borgel/BotBall/EE/BB-Mainboard-0/BB-Mainboard-0.step

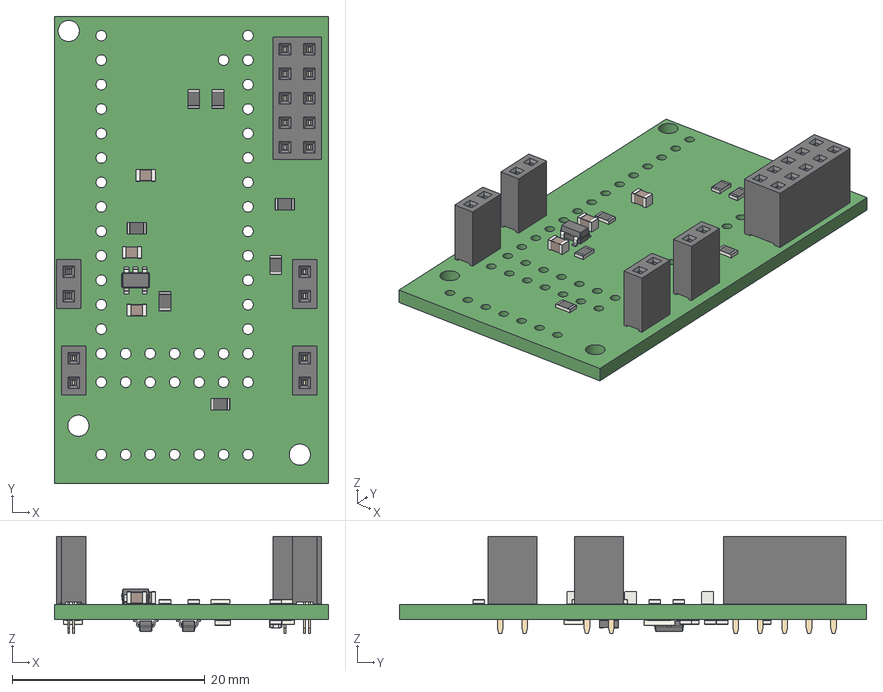
[picture p1: CAD file, 2019-11-15]
EE/BB-Mainboard-0/BB-Mainboard-0.step
28.5 x 48.5 x 10.1 mm
