borgel/BotBall/ME/1x Chassis.stl

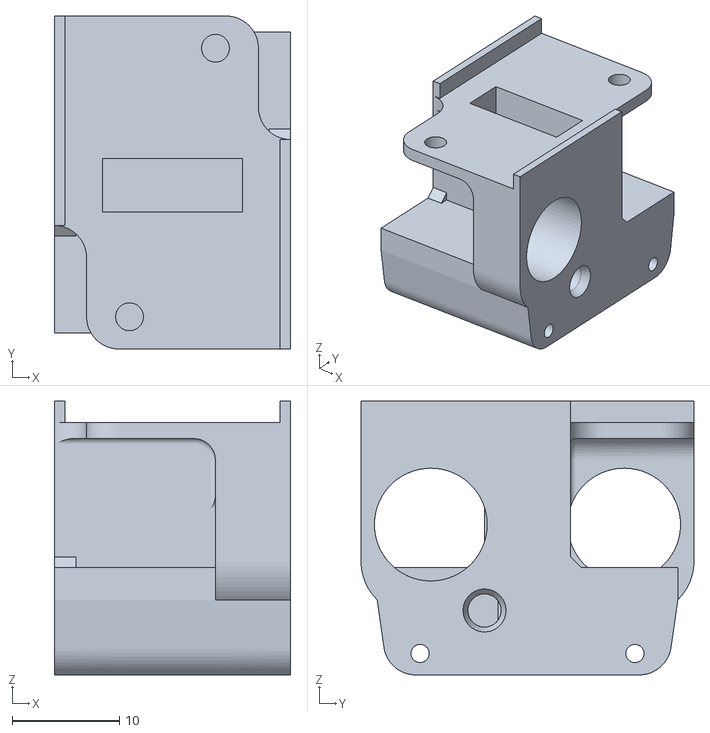
[picture p2: CAD file, 2019-11-15]
ME/1x Chassis.stl
22.0 x 31.0 x 25.5
