borgel/BotBall/ME/1x Top Half.stl

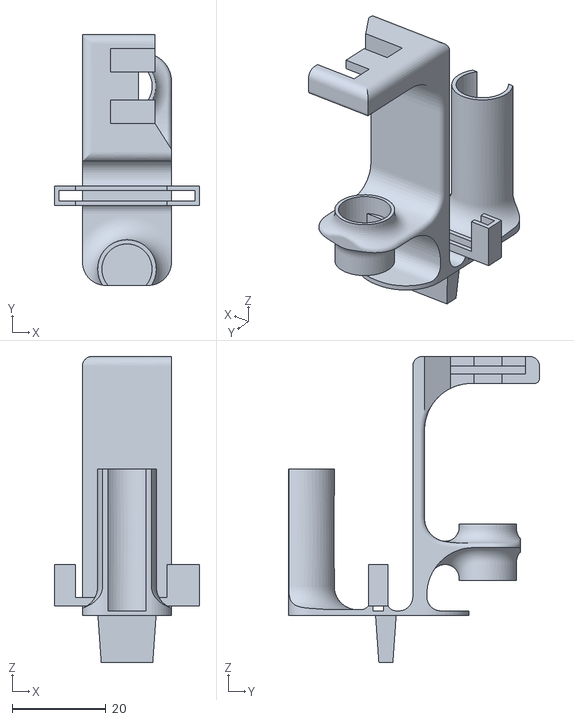
[picture p3: CAD file, 2019-11-15]
ME/1x Top Half.stl
31.0 x 53.5 x 65.3
