borgel/BotBall/ME/2x Pinion.stl

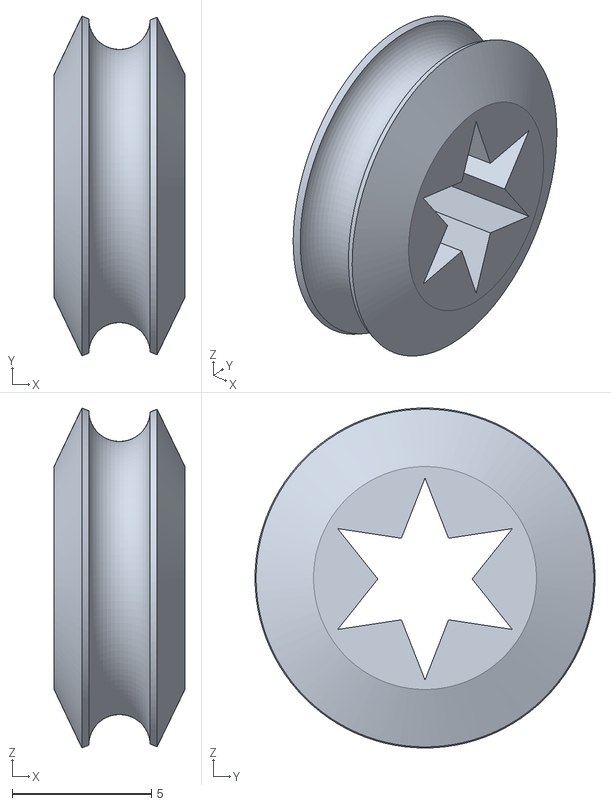
[picture p4: CAD file, 2019-11-15]
ME/2x Pinion.stl
4.70 x 12.2 x 12.2
