borgel/BotBall/ME/4x Idler.stl

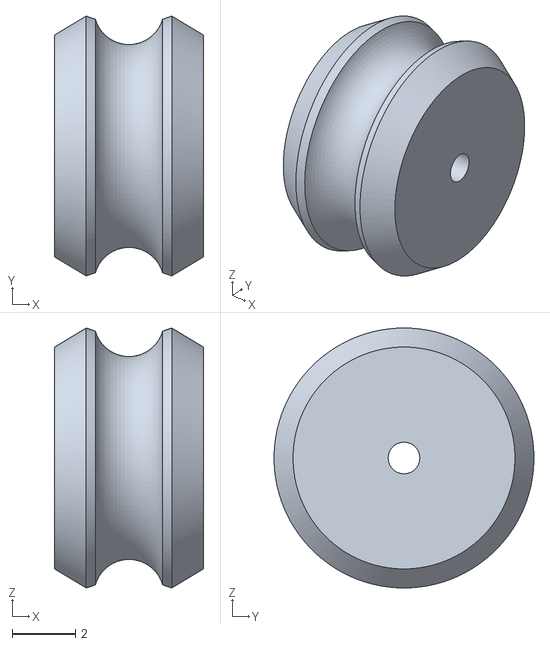
[picture p5: CAD file, 2019-11-15]
ME/4x Idler.stl
4.70 x 8.20 x 8.20
