borgel/BotBall/ME/2x Side Plate.stl

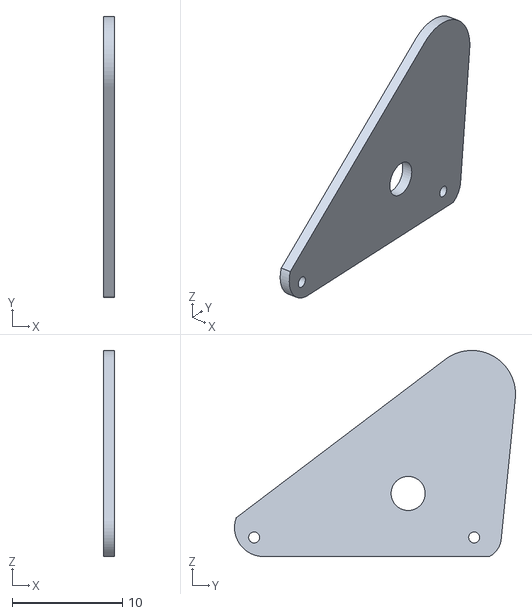
[picture p6: CAD file, 2019-11-15]
ME/2x Side Plate.stl
1.00 x 25.5 x 18.7
