borgel/BotBall/EE/BB-Mainboard-0/BB-Mainboard-0.pdf

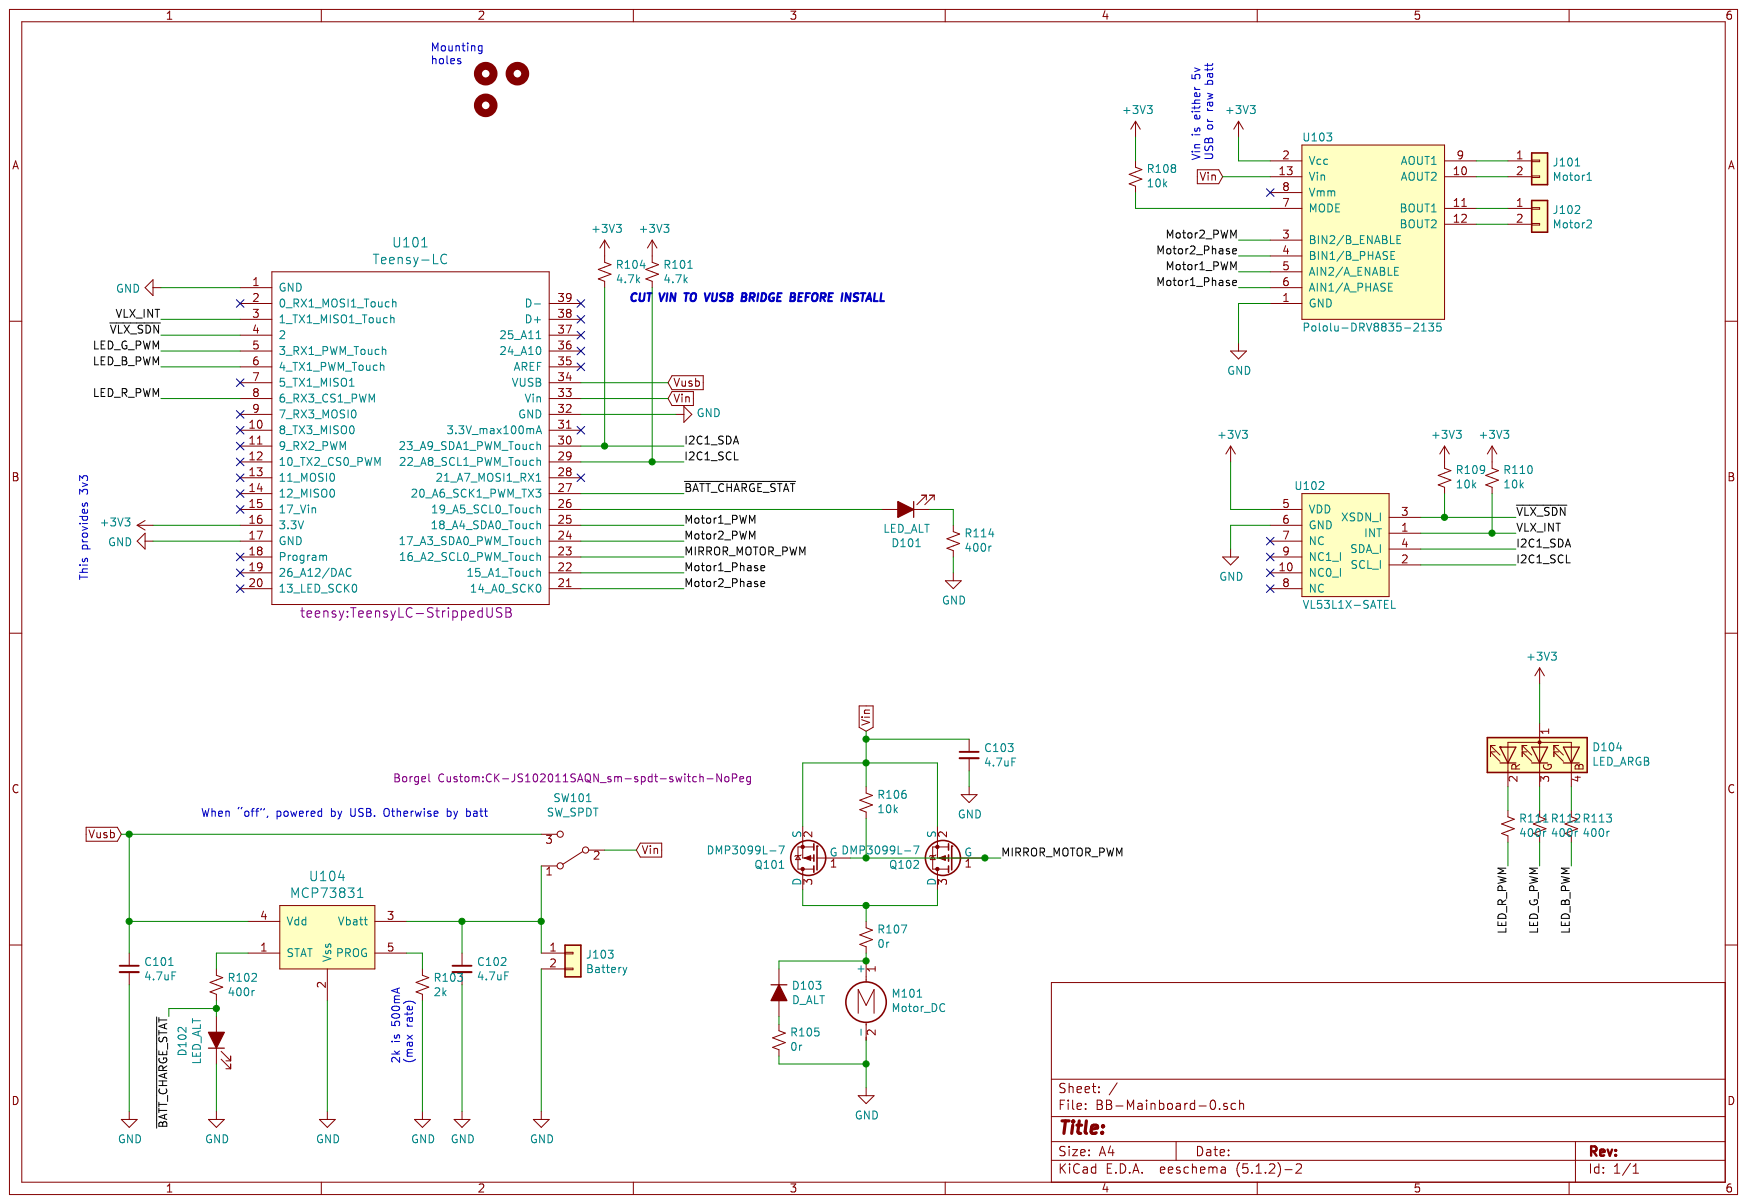
[picture p7: page 1]
