borgel/BotBall/EE/BB-Mainboard-0/BB-Mainboard-0.kicad_pcb

## KiCad design EE/BB-Mainboard-0/BB-Mainboard-0.kicad_pcb (2019-11-15)

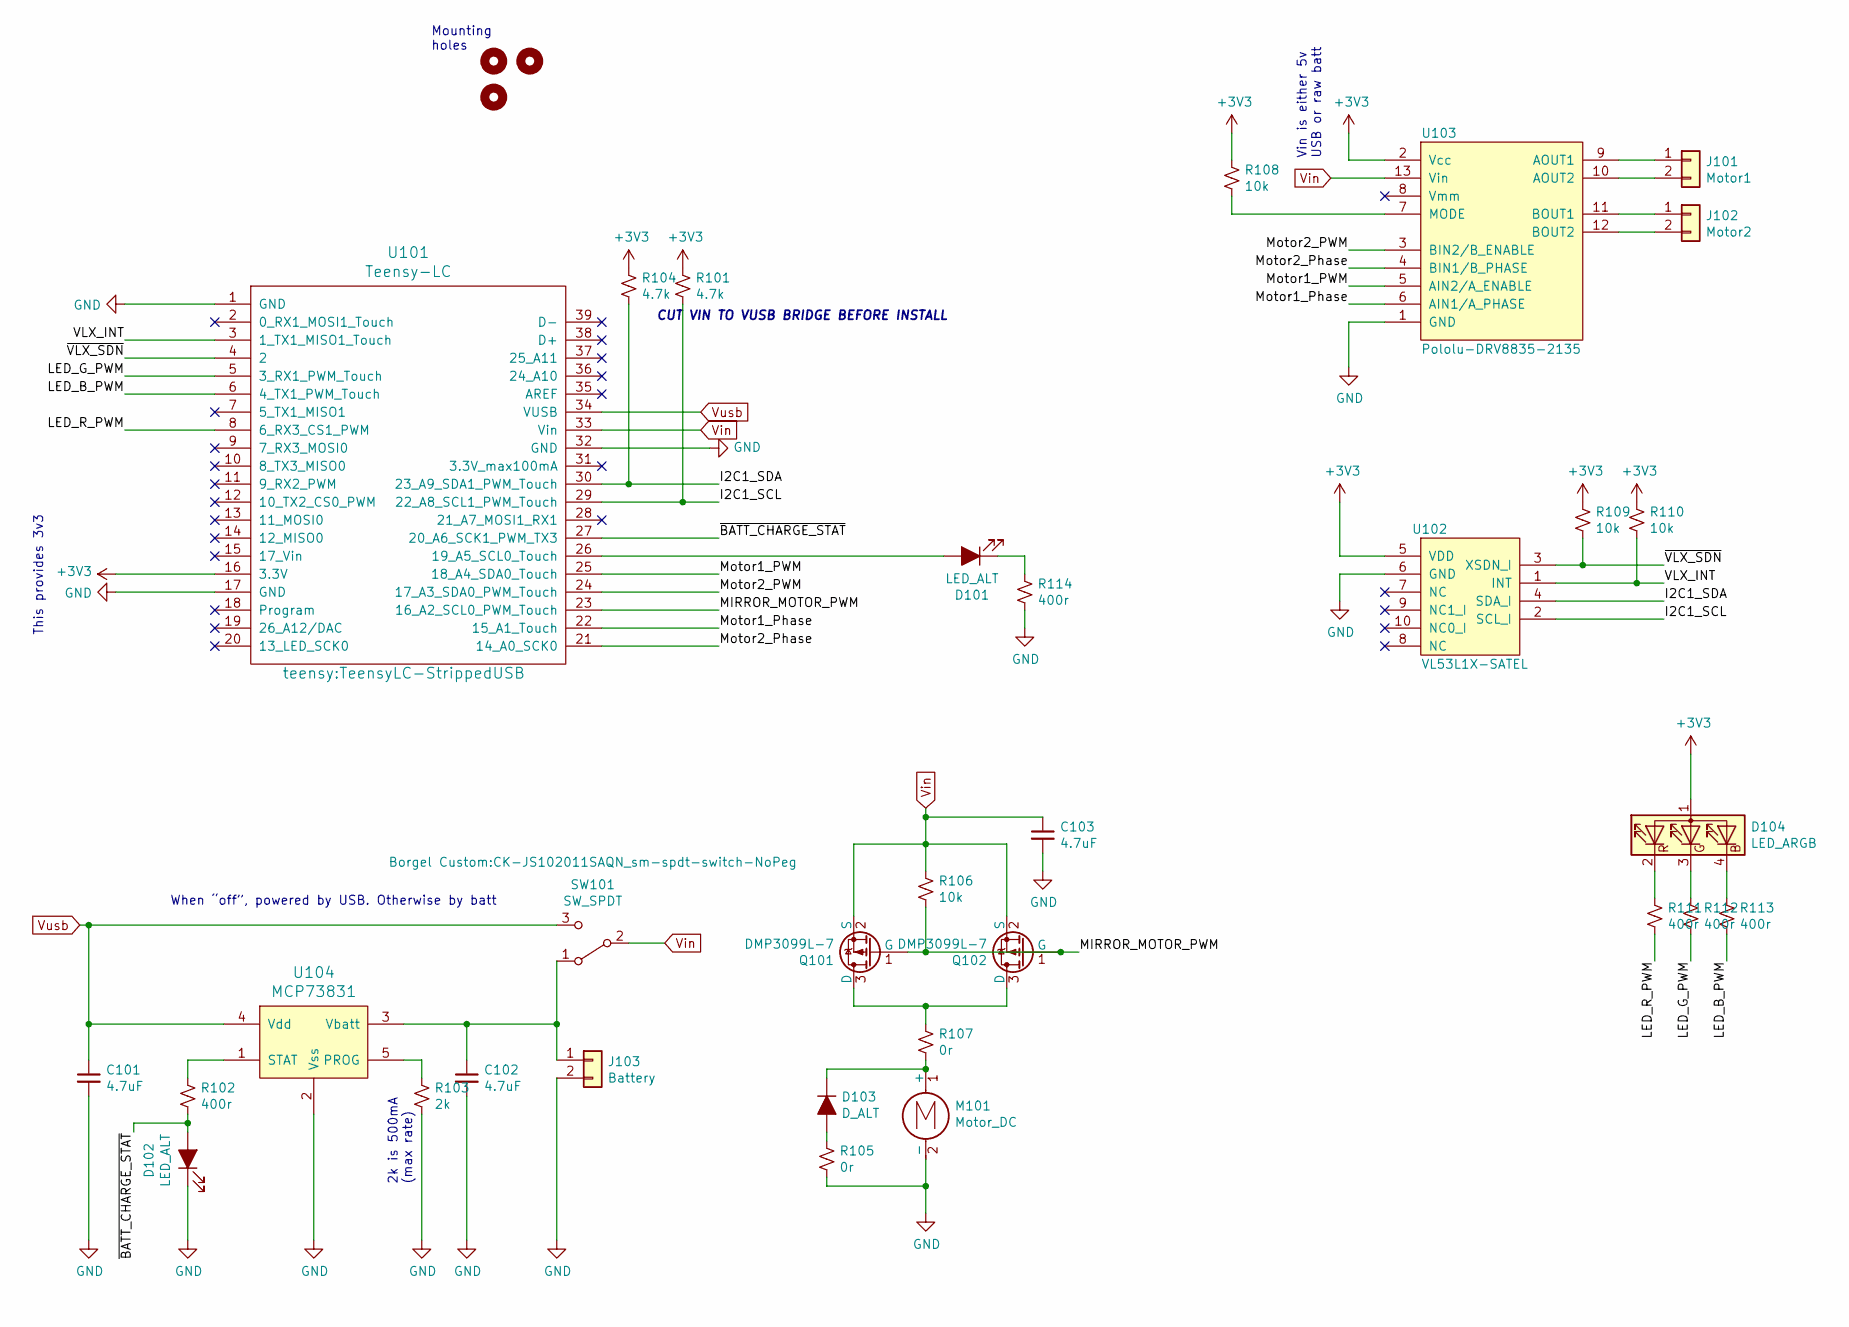
[picture p8: schematic BB-Mainboard-0.sch]

Parts:
C101, C102, C103: 4.7uF; C_0805_2012Metric
D101, D102: LED_ALT; LED_0603_SmallSilk
D103: D_ALT; D_0805_2012Metric
D104: LED_ARGB; LED_Kingbright_AAA3528ESGCT
H101, H102, H103: MountingHole; MountingHole_2.2mm_M2
J101: Motor1; PinSocket_1x02_P2.54mm_Vertical
J102: Motor2; PinSocket_1x02_P2.54mm_Vertical
J103: Battery; PinSocket_1x02_P2.54mm_Vertical
M101: Motor_DC; PinSocket_1x02_P2.54mm_Vertical
Q101, Q102: DMP3099L-7; SOT-23; DigiKey DMP3099L-7DICT-ND
R101, R104: 4.7k; R_0805_2012Metric
R102, R111, R112, R113, R114: 400r; R_0805_2012Metric
R103: 2k; R_0805_2012Metric
R105: 0r; R_0805_2012Metric
R106, R108, R109, R110: 10k; R_0805_2012Metric
R107: 0r; R_1206_3216Metric
SW101: SW_SPDT; CK-JS102011SAQN_sm-spdt-switch-NoPeg
U101: Teensy-LC; TeensyLC-StrippedUSB
U102: VL53L1X-SATEL; PinSocket_2x05_P2.54mm_Vertical
U103: Pololu-DRV8835-2135; Pololu-DRV8835-Carrier
U104: MCP73831; SOT-23-5

Connections:
+3V3: D104.1 (A), R101.1, R104.1, R108.2, R109.2, R110.2, U101.16 (3.3V), U102.5 (VDD), U103.2 (Vcc)
/I2C1_SCL: R101.2, U101.29 (22_A8_SCL1_PWM_Touch), U102.2 (SCL_I)
/I2C1_SDA: R104.2, U101.30 (23_A9_SDA1_PWM_Touch), U102.4 (SDA_I)
/LED_B_PWM: R113.1, U101.6 (4_TX1_PWM_Touch)
/LED_G_PWM: R112.1, U101.5 (3_RX1_PWM_Touch)
/LED_R_PWM: R111.1, U101.8 (6_RX3_CS1_PWM)
/MIRROR_MOTOR_PWM: Q101.1 (G), Q102.1 (G), R106.1, U101.23 (16_A2_SCL0_PWM_Touch)
/Motor1_PWM: U101.25 (18_A4_SDA0_Touch), U103.5 (AIN2/A_ENABLE)
/Motor1_Phase: U101.22 (15_A1_Touch), U103.6 (AIN1/A_PHASE)
/Motor2_PWM: U101.24 (17_A3_SDA0_PWM_Touch), U103.3 (BIN2/B_ENABLE)
/Motor2_Phase: U101.21 (14_A0_SCK0), U103.4 (BIN1/B_PHASE)
/VLX_INT: R110.1, U101.3 (1_TX1_MISO1_Touch), U102.1 (INT)
/~BATT_CHARGE_STAT: D102.2 (A), R102.2, U101.27 (20_A6_SCK1_PWM_TX3)
/~VLX_SDN: R109.1, U101.4 (2), U102.3 (XSDN_I)
GND: C101.2, C102.2, C103.2, D102.1 (K), J103.2, M101.2 (-), R103.2, R105.1, R114.1, U101.1 (GND), U101.17 (GND), U101.32 (GND), U102.6 (GND), U103.1 (GND), U103.14 (GND), U104.2 (Vss)
unnamed: C102.1, J103.1, SW101.1 (A), U104.3 (Vbatt)
unnamed: D101.1 (K), R114.2
unnamed: D101.2 (A), U101.26 (19_A5_SCL0_Touch)
unnamed: D103.1 (K), M101.1 (+), R107.1
unnamed: D103.2 (A), R105.2
unnamed: D104.2 (RK), R111.2
unnamed: D104.3 (GK), R112.2
unnamed: D104.4 (BK), R113.2
unnamed: J101.1, U103.9 (AOUT1)
unnamed: J101.2, U103.10 (AOUT2)
unnamed: J102.1, U103.11 (BOUT1)
unnamed: J102.2, U103.12 (BOUT2)
unnamed: Q101.3 (D), Q102.3 (D), R107.2
unnamed: R102.1, U104.1 (STAT)
unnamed: R103.1, U104.5 (PROG)
unnamed: R108.1, U103.7 (MODE)
Vin: C103.1, Q101.2 (S), Q102.2 (S), R106.2, SW101.2 (B), U101.33 (Vin), U103.13 (Vin)
Vusb: C101.1, SW101.3 (C), U101.34 (VUSB), U104.4 (Vdd)

Notes on the sheet:
2k is 500mA (max rate)
When “off”, powered by USB. Otherwise by batt
CUT VIN TO VUSB BRIDGE BEFORE INSTALL
This provides 3v3
Vin is either 5v USB or raw batt
Mounting holes

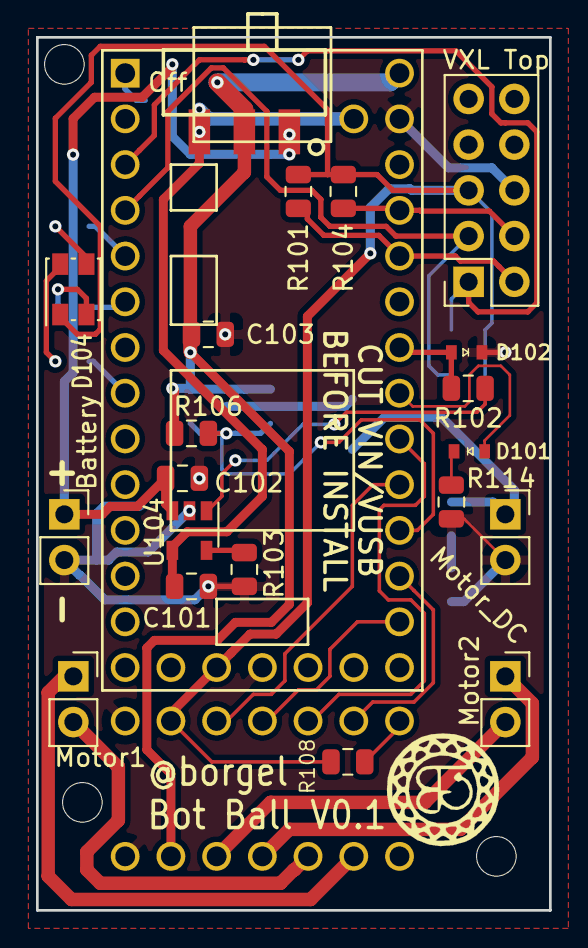
[picture p9: board BB-Mainboard-0.kicad_pcb from above]

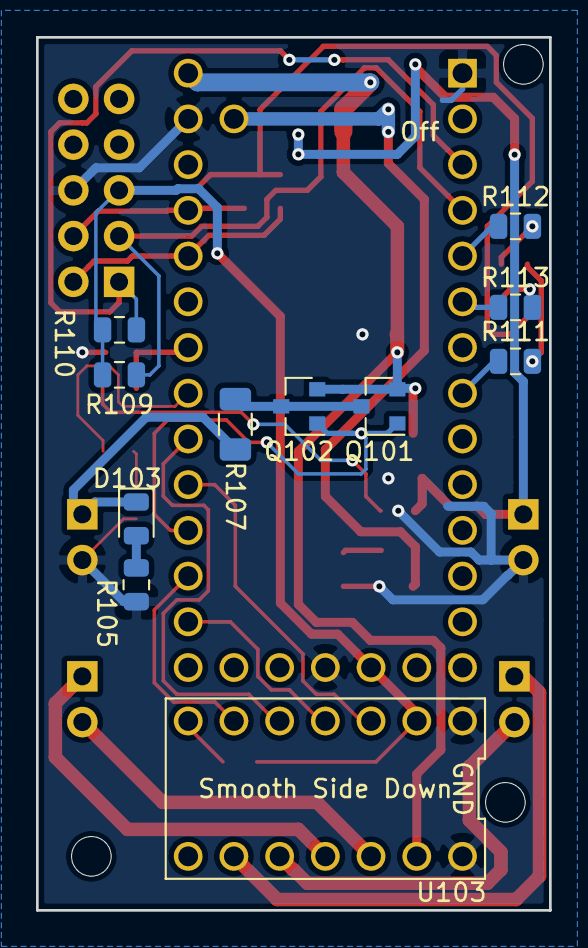
[picture p10: board BB-Mainboard-0.kicad_pcb from below]

Board: 2 copper layers, 28.5 x 48.5 mm, 35 parts (11 on the bottom side), 33 nets.
