borgel/BotBall/BotBall-FW0/BotBall-FW0.ino

#include "IntervalTimer.h"
#include "rotary.h"
#include "navigation.h"
#include "hw.h"

// motor driver
// https://www.pololu.com/product/2135

void setup() {
  // status LED
  pinMode(ledPin, OUTPUT);
  digitalWrite(ledPin, HIGH);

  pinMode(ledRPin, OUTPUT);
  pinMode(ledGPin, OUTPUT);
  pinMode(ledBPin, OUTPUT);
  digitalWrite(ledRPin, HIGH);
  digitalWrite(ledGPin, HIGH);
  digitalWrite(ledBPin, HIGH);

  delay(2000);

  Serial.begin(115200);
  Serial.println("Booted...");

  nav_Begin();

  rotary_Begin();
  // do it again to avoid any partial homes
  rotary_Begin();
}

void loop() {
  rotary_Home();
  rotary_ScanContinuous();
  // only returns if it needs to re-home

  // TODO reset drive?
}
