borgel/BotBall/BotBall-FW0/navigation.cpp

#include "navigation.h"
#include "hw.h"

#include <Arduino.h>

static const int targetDistanceMm = 50;

// spacial resolution isn't that good...
static const int targetRelHeadingErrorDeg = 25;

// below a total of about 120 counts a side wont drive
static const int motorBaseSpeed = 120;
static const int motorASpeedTrim = 10;    //right tread
static const int motorBSpeedTrim = 80;

enum TrackingState {
  TS_UNKNOWN,
  TS_NO_TARGET,
  TS_SEEKING,
  TS_ARRIVED,
};

static struct {
  enum TrackingState tracState;
  int noTargetCount;

  int targetRangeMm;
  int targetHeadingRel;

  int currentBaseVeloc;
} state = {};

static void programMotors(void);

void nav_Begin(void) {
  memset(&state, 0, sizeof(state));
  state.tracState = TS_NO_TARGET;

  // setup PWM and direction pins
  pinMode(phaseAPin, OUTPUT);
  pinMode(phaseBPin, OUTPUT);
  pinMode(pwmAPin, OUTPUT);
  pinMode(pwmBPin, OUTPUT);

  // FIXME rm
  /*
    state.currentBaseVeloc = motorBaseSpeed;
    int16_t speedA = state.currentBaseVeloc + motorASpeedTrim;
    int16_t speedB = state.currentBaseVeloc + motorBSpeedTrim;

    if (speedA < 0) {
    digitalWrite(phaseAPin, HIGH);
    }
    else {
    digitalWrite(phaseAPin, LOW);
    }

    if (speedB < 0) {
    digitalWrite(phaseBPin, LOW);
    }
    else {
    digitalWrite(phaseBPin, HIGH);
    }

    // set the actual speed
    analogWrite(pwmAPin, speedA);
    analogWrite(pwmBPin, speedB);

    while(1) {}
  */
}

// clockwise is positive, in degrees
void nav_SetHeadingOffset(int16_t const headingCCPDeg) {
  state.targetHeadingRel = headingCCPDeg;
  Serial.printf("New rel heading: %d*\n", state.targetHeadingRel);
  programMotors();
}

void nav_SetRange(uint16_t const newRangeMm) {
  state.targetRangeMm = newRangeMm;
  Serial.printf("New range: %dmm", state.targetRangeMm);
  programMotors();
}

void nav_NoTarget(void) {
  //state.noTargetCount++;
  //programMotors();
}

// tells us if we are facing directly at the target, and it is within the range
static bool haveArrivedAtTarget(void) {
  return state.targetRangeMm <= targetDistanceMm &&
         abs(state.targetHeadingRel) < targetRelHeadingErrorDeg;
}

static void programMotors(void) {
  if (state.noTargetCount > 6 && state.tracState == TS_SEEKING) {
    state.noTargetCount = 0;
    // assume we have lost the target
    state.tracState = TS_NO_TARGET;
    Serial.println("No target");
  }

  // set blue LED for status
  if (state.tracState == TS_ARRIVED) {
    // done!
    digitalWrite(ledBPin, HIGH);
  }
  else if (state.tracState != TS_UNKNOWN) {
    digitalWrite(ledBPin, LOW);
  }

  // if there is an error to target, navigate
  if (haveArrivedAtTarget() ) {
    state.tracState = TS_ARRIVED;

    Serial.println("Arrived!\n\n");

    analogWrite(pwmAPin, 0);
    analogWrite(pwmBPin, 0);
    return;
  }
  // else, there is navigation to do
  state.tracState = TS_SEEKING;
  state.noTargetCount = 0;

  // adjust base speed based on range
  int rangeDelta = state.targetRangeMm - targetDistanceMm;
  if (rangeDelta > 0) {
    // TODO make this...proportional
    state.currentBaseVeloc = motorBaseSpeed;
  }
  else {
    state.currentBaseVeloc = 0;
  }

  int16_t speedA = state.currentBaseVeloc + motorASpeedTrim;
  int16_t speedB = state.currentBaseVeloc + motorBSpeedTrim;


  digitalWrite(phaseAPin, LOW);
  digitalWrite(phaseBPin, HIGH);

  if (abs(state.targetHeadingRel) < targetRelHeadingErrorDeg) {
    // straight
  }
  else {

    // FIXME move to top
    int16_t const turn = 10;
    if (state.targetHeadingRel < 0) {
      speedB = 0;
    }
    else if (state.targetHeadingRel > 0) {
      speedA = 0;
    }
  }

  // set the actual speed
  analogWrite(pwmAPin, speedA);
  analogWrite(pwmBPin, speedB);
}
