borgel/BotBall/BotBall-FW0/hw.h

// hardware/pin defs
#pragma once

// white status LED
const int ledPin = 19;

// RGB LED
const int ledRPin = 6;
const int ledGPin = 3;
const int ledBPin = 4;

// driving motors
const int pwmAPin = 18;
const int pwmBPin = 17;
const int phaseAPin = 15;
const int phaseBPin = 18;
