borgel/BotBall/(commit log)

2019-10-28 Update pin assignments
2019-10-28 Add RGB LED
2019-10-29 Proof of concept open-drain PWM
2019-10-29 WIP encapsulate open drain PWM
2019-11-01 LIDAR works!
2019-11-01 Push LIDAR into a separate module
2019-11-08 Early draft of homing routine
2019-11-08 Starting to cleanup homing
2019-11-09 Better filtering on distance measurements
2019-11-10 Use fast GPIO in PWM CB
2019-11-10 Rework getDistance and backstop criteria
    [rotary.cpp]
2019-11-10 Calibrate crosstalk
2019-11-10 Allow PWM to be paused and resumed
2019-11-14 Trim motors to drive approximately straight
2019-11-15 Add chassis STLs
    [1x Chassis.stl, 1x Top Half.stl, 2x Pinion.stl, 2x Side Plate.stl, 4x Idler.stl]
2019-11-15 Add EE sources
    [BB-Mainboard-0-B_Cu.gbl, BB-Mainboard-0-B_Mask.gbs, BB-Mainboard-0-B_Paste.gbp, BB-Mainboard-0-B_SilkS.gbo, BB-Mainboard-0-Edge_Cuts.gm1, BB-Mainboard-0-F_Cu.gtl, BB-Mainboard-0-F_Mask.gts, BB-Mainboard-0-F_Paste.gtp]
